EEE3088/EEE3088_team/initial_schematic/Sensor_Schematics_Screenshots/Digital_Pressure_Sensor_schematic_v0.1.png

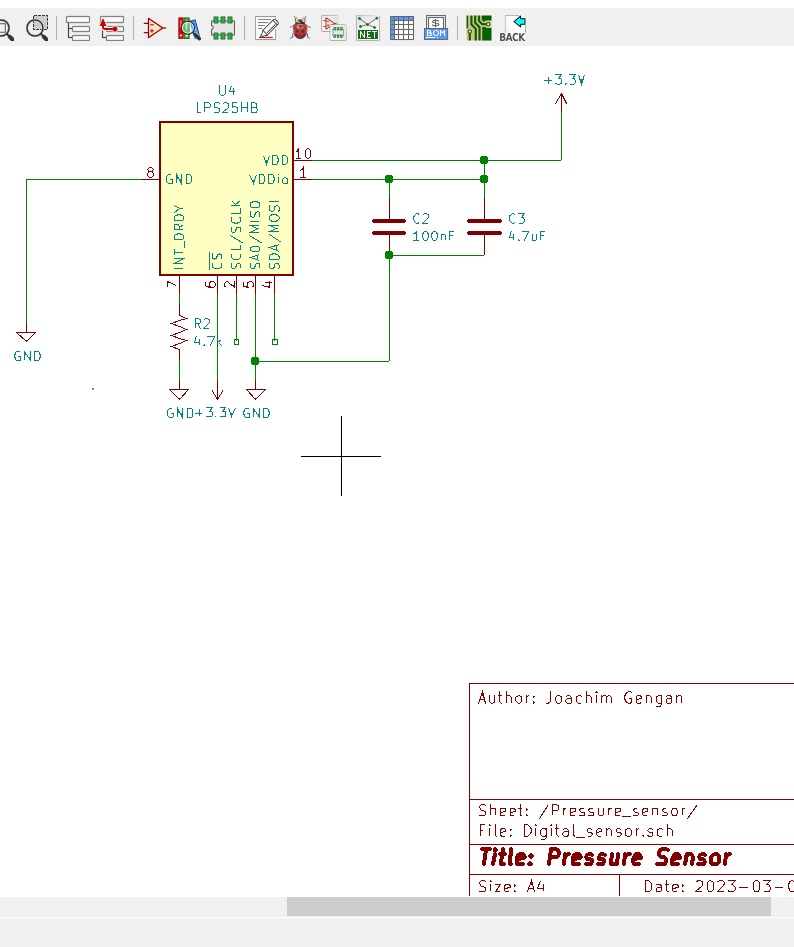
initial_schematic/Sensor_Schematics_Screenshots/Digital_Pressure_Sensor_schematic_v0.1.png
