EEE3088/EEE3088_team/main_v0.35/AT24C256C-SSHL-T/AT24C256C-SSHL-T.step

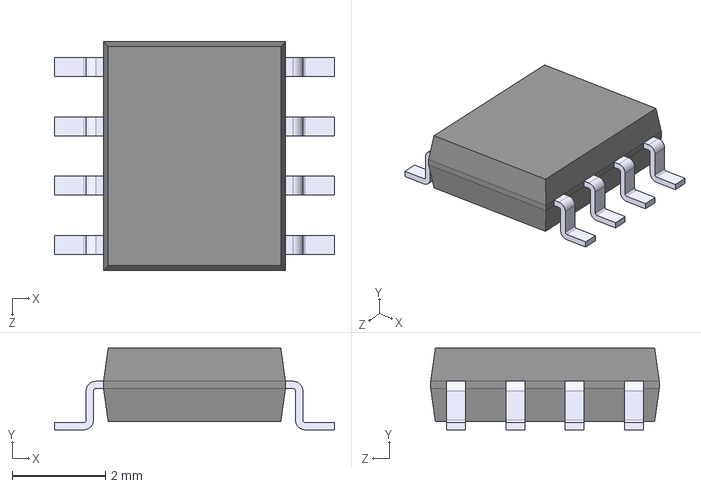
[picture p4: CAD file, 2023-04-24]
main_v0.35/AT24C256C-SSHL-T/AT24C256C-SSHL-T.step
6.00 x 1.75 x 4.90 mm
