EEE3088/EEE3088_team/main_v0.35/DW01A/DW01A.step

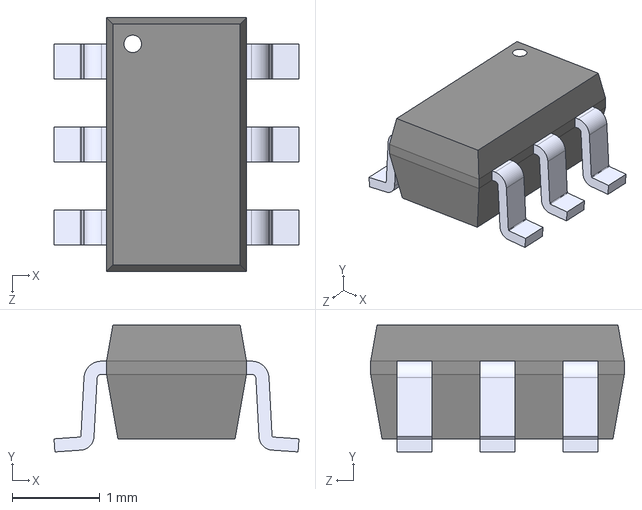
[picture p5: CAD file, 2023-04-11]
main_v0.35/DW01A/DW01A.step
2.80 x 1.45 x 2.90 mm
