EEE3088/EEE3088_team/main_v0.35/FS8205A/FS8205A.step

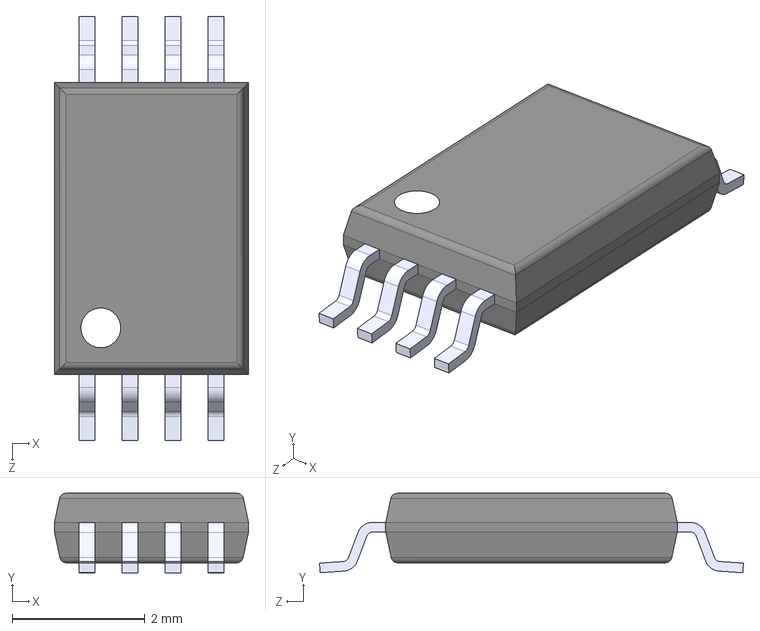
[picture p6: CAD file, 2023-04-11]
main_v0.35/FS8205A/FS8205A.step
2.93 x 1.20 x 6.40 mm
