EEE3088/EEE3088_team/main_v0.35/FT234XD-R.step

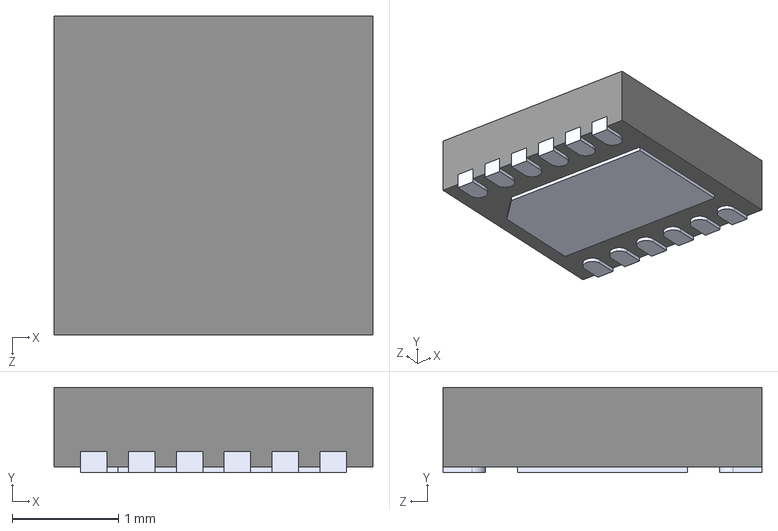
[picture p7: CAD file, 2023-04-11]
main_v0.35/FT234XD-R.step
3.00 x 0.8 x 3.00 mm
