EEE3088/EEE3088_team/main_v0.35/TP4056/TP4056.step

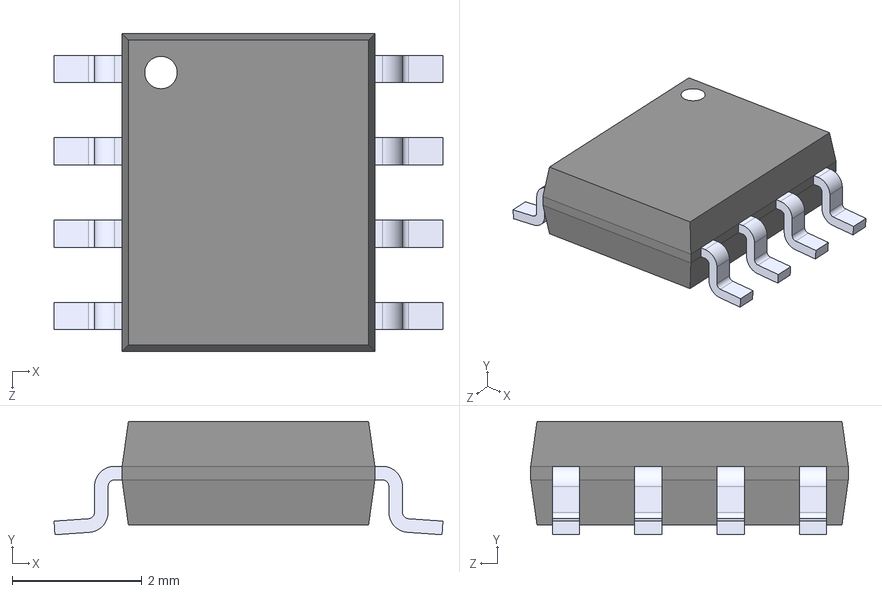
[picture p8: CAD file, 2023-04-11]
main_v0.35/TP4056/TP4056.step
6.00 x 1.75 x 4.90 mm
