EEE3088/EEE3088_team/main_v0.35/CSD13381F4/CSD13381F4.step

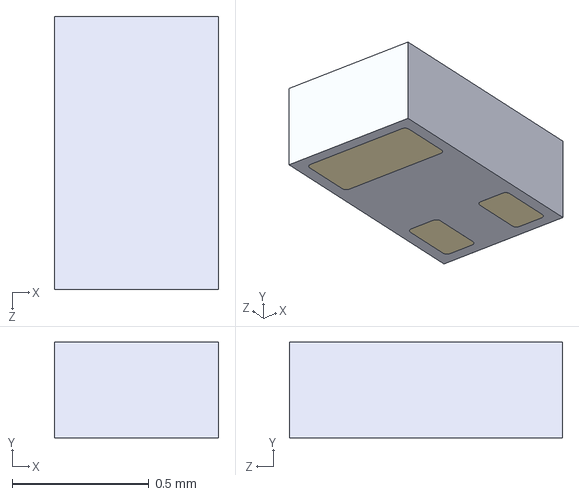
[picture p9: CAD file, 2023-04-24]
main_v0.35/CSD13381F4/CSD13381F4.step
0.6 x 0.35 x 1.00 mm
