EEE3088/EEE3088_team/main_v0.35/TPS61022RWUR/TPS61022RWUR.step

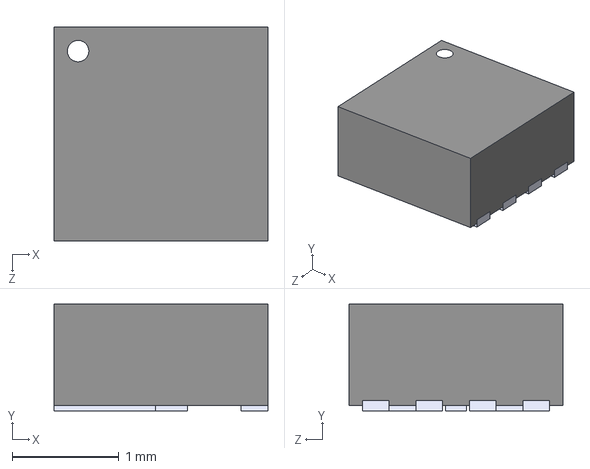
[picture p10: CAD file, 2023-04-24]
main_v0.35/TPS61022RWUR/TPS61022RWUR.step
2.00 x 1.00 x 2.00 mm
