EEE3088/EEE3088_team/(list of files, cad)

Other CAD files:
main_v0.17/CAT24C256WI-G.step
main_v0.17/CAT24C256WI-G/CAT24C256WI-G.step
