EEE3088/EEE3088_team/(list of files, drawings)

Other design files:
main_v0.17/main_v0.6(2).dsn
main_v0.17/main_v0.6.dsn
main_v0.17/main_v0.7.dsn
main_v0.17/main_v0.8.dsn
