EEE3088/EEE3088_team/(commit log)

2023-02-27 Create PCB_design
2023-03-05 Created new folder, moved in Bom file to new folder
    [Sensor_BOM.csv]
2023-03-05 Uploaded initial schematics
    [Digital sensor.sch, Temperature_sensor.sch]
2023-03-05 Removed older version of Sensor Bom
    [Sensor_BOM.csv]
2023-03-05 Updated Sensor schematics
    [Digital sensor.sch, Temperature_sensor.sch]
2023-03-05 Updated files
    [Sensor_BOMv0.1.csv]
2023-03-06 Create Power screenshots
2023-03-13 Updated Sensor BOM
    [Sensor_BOMv0.1.csv, updatedSensorBomv0.1.csv]
2023-03-14 Updated Power Bom
    [PowerSchematicNew.csv, PowerSchematicNew1.csv]
2023-03-20 Added Gerber Files to folder 'pcb'
    [main_v0.6-B_Cu.gbl, main_v0.6-B_Mask.gbs, main_v0.6-B_Paste.gbp, main_v0.6-B_Silkscreen.gbo, main_v0.6-Edge_Cuts.gm1, main_v0.6-F_Cu.gtl, main_v0.6-F_Mask.gts, main_v0.6-F_Paste.gtp]
